oskarhuotari/HeartPCBGift/Stand.step

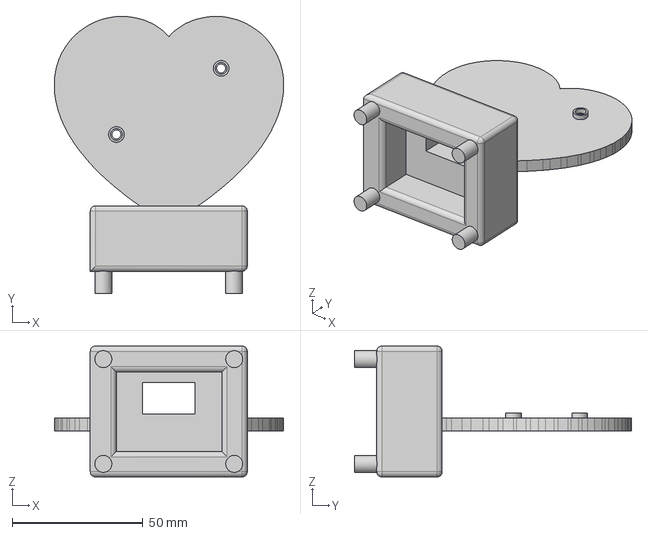
[picture p1: CAD file, 2026-10-22]
Stand.step
87.7 x 105.8 x 50.0 mm
