oskarhuotari/HeartPCBGift/schematic.pdf

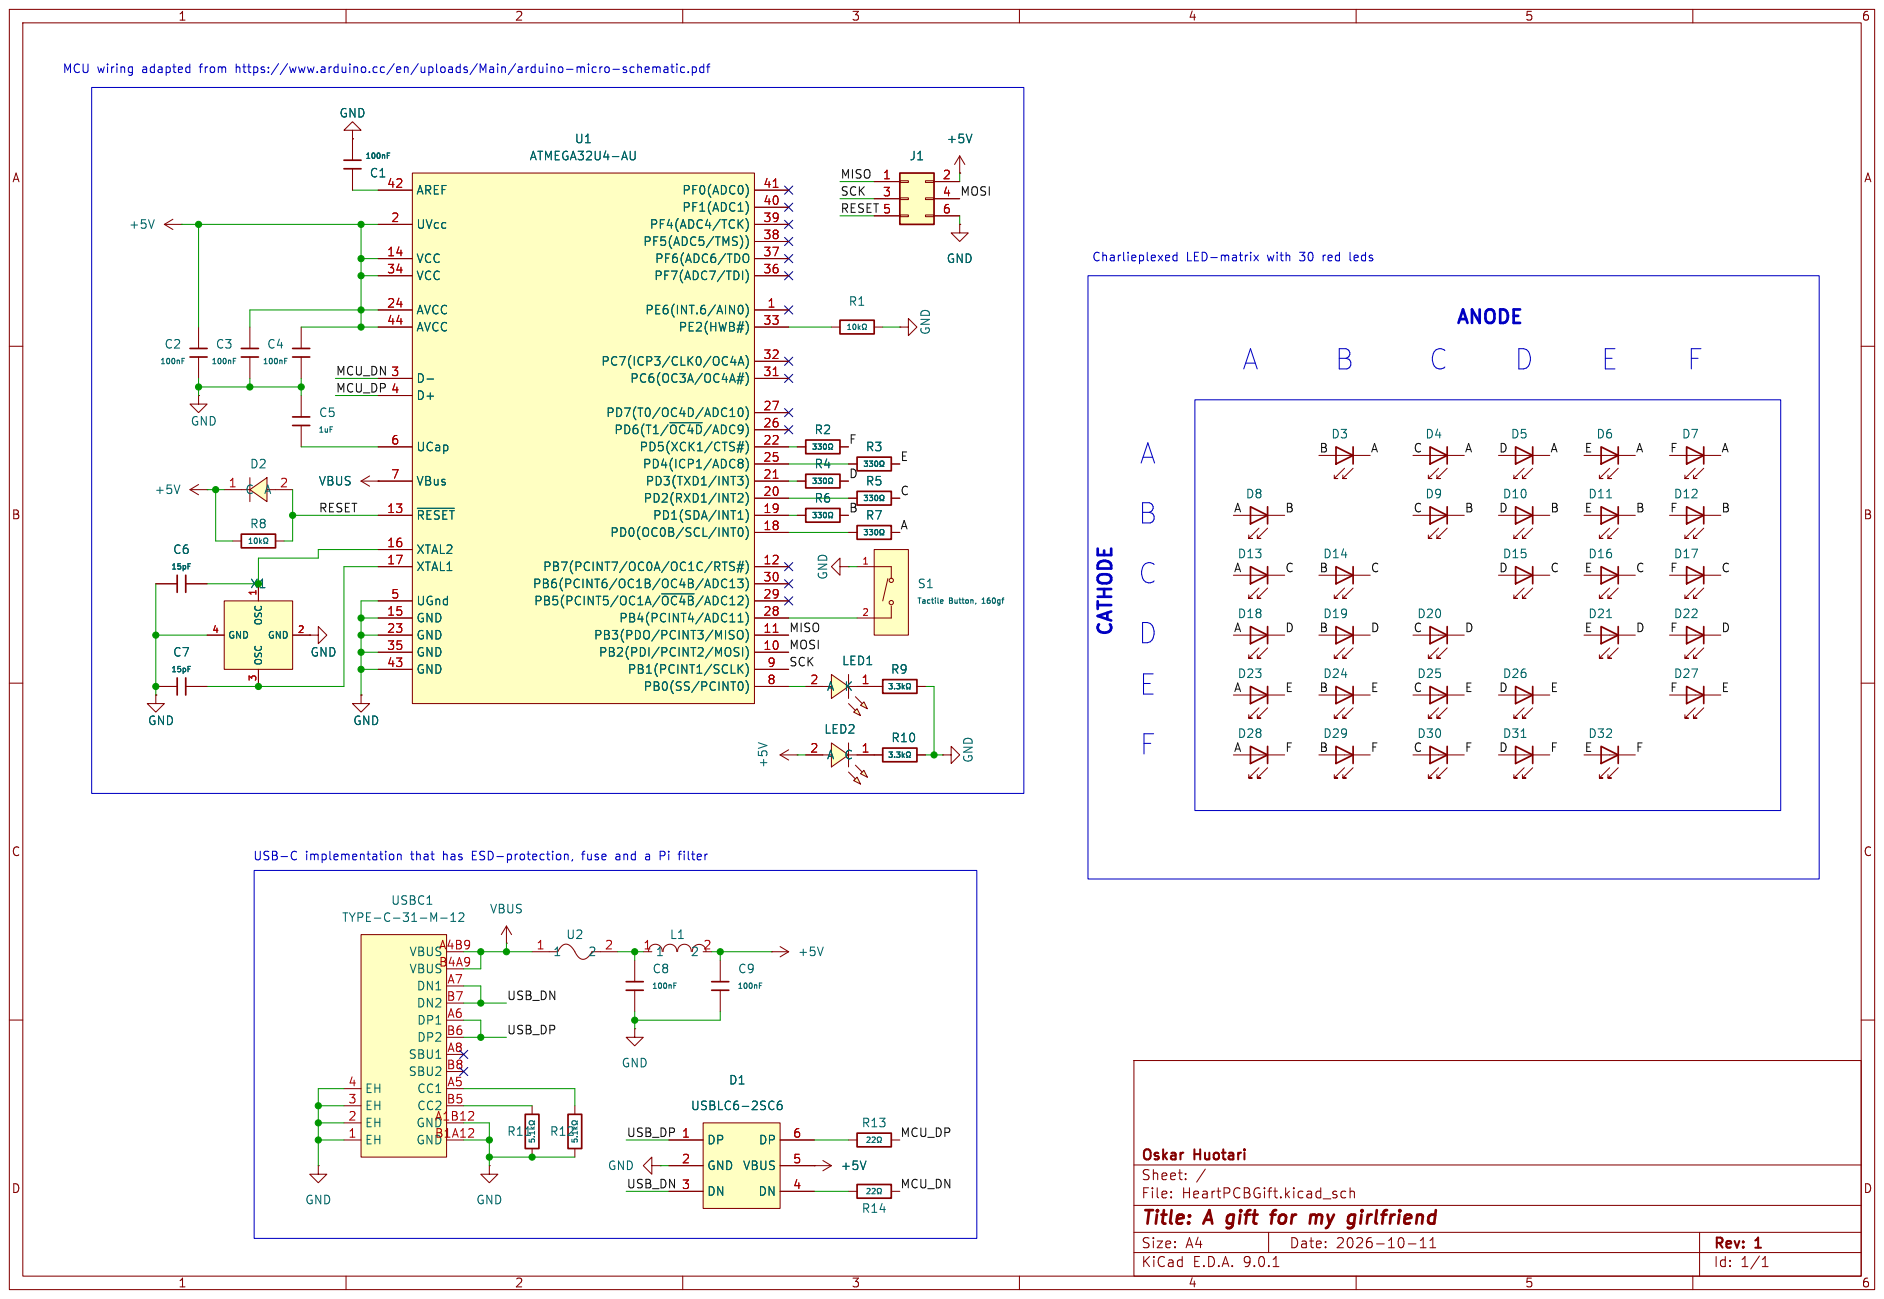
[picture p2: page 1]

MCU wiring adapted from https://www.arduino.cc/en/uploads/Main/arduino-micro-schematic.pdf

Id: 1/1 Title: A gift for my girlfriend
