oskarhuotari/HeartPCBGift/HeartPCBGift.kicad_pcb

## KiCad design HeartPCBGift.kicad_pcb (2026-10-20)

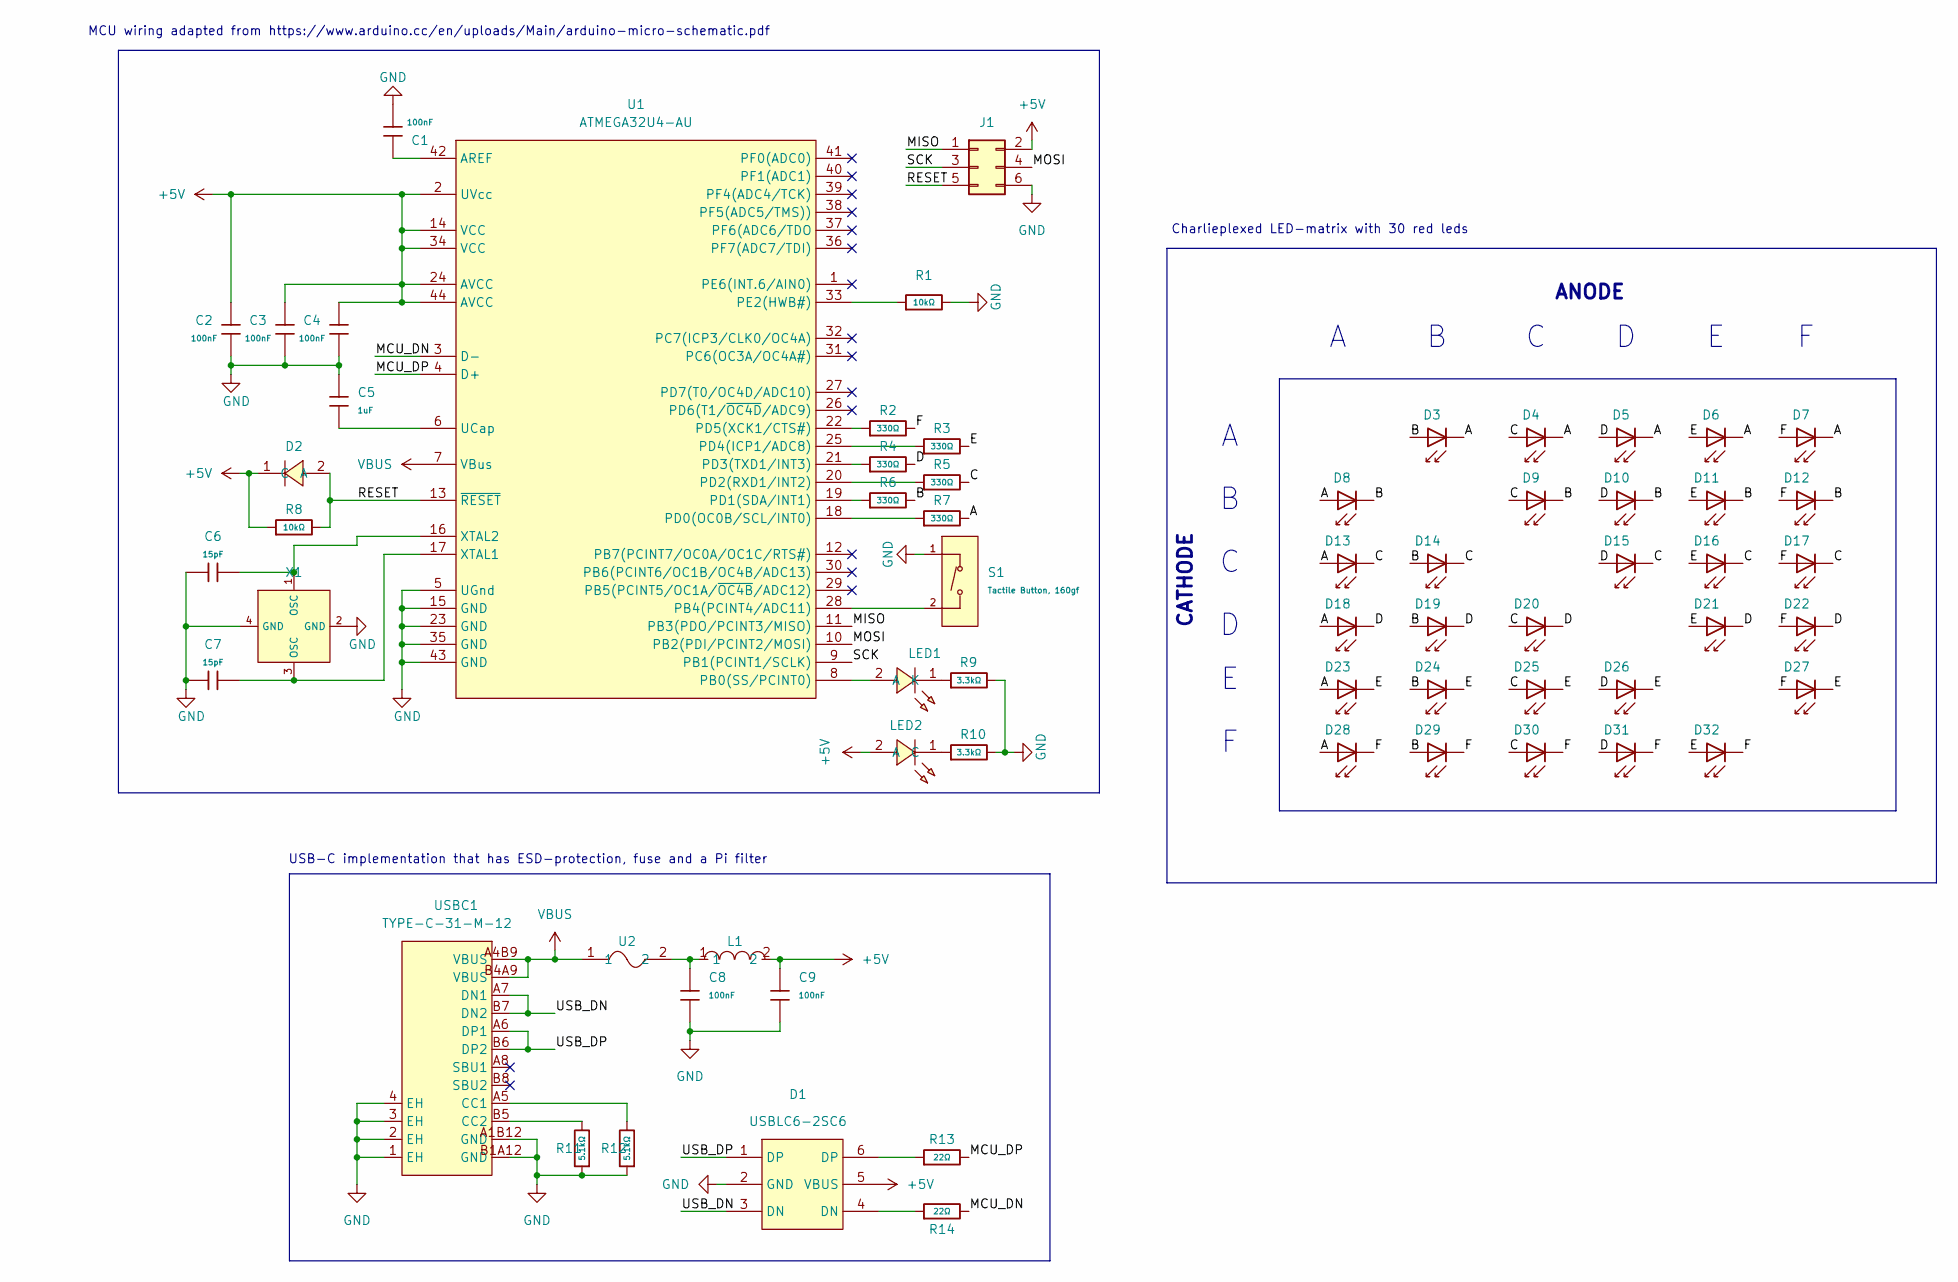
[picture p3: schematic HeartPCBGift.kicad_sch, A gift for my girlfriend]

Parts:
C1, C2, C3, C4, C8, C9: 100nF; C_0603; Voltage Rated 50V; Tolerance ±10%; Part CC0603KRX7R9BB104; LCSC C14663
C5: 1uF; C_0603; Voltage Rated 50V; Tolerance ±10%; Part CL10A105KB8NNNC; LCSC C15849
C6, C7: 15pF; C_0603; Voltage Rated 50V; Tolerance ±5%; Part CL10C150JB8NNNC; LCSC C1644
D1: USBLC6-2SC6; SOT-23-6_L2.9-W1.6-P0.95-LS2.8-BL; MPN USBLC6-2SC6; LCSC Part C7519
D2: 1N4448W_C5190208; SOD-123_L2.7-W1.6-LS3.7-RD; MPN 1N4448W; LCSC Part C5190208
D3, D4, D5, D6, D7, D8, D9, D10, D11, D12, D13, D14, D15, D16, D17, D18, D19, D20, D21, D22, D23, D24, D25, D26, D27, D28, D29, D30, D31, D32: Red; D_0805; Forward Voltage (VF) 1.6V~2.6V; Part NCD0805R1; LCSC C84256
J1: Conn_02x03_Odd_Even; PinHeader_2x03_P2.54mm_Vertical
L1: MPZ1608D101BTA00; L0603; MPN MPZ1608D101BTA00; LCSC Part C87554
LED1: XL-1608UBC-04; LED0603-RD_BLUE; MPN XL-1608UBC-04; LCSC Part C965807
LED2: F.0603.00025/P2-0603G1TS2-06T-002; LED0603-RD_GREEN; MPN F.0603.00025/P2-0603G1TS2-06T-002; LCSC Part C7496818
R1, R8: 10kΩ; R_0603; Overload Voltage (Max) 75V; Tolerance ±1%; Part 0603WAF1002T5E; LCSC C25804
R2, R3, R4, R5, R6, R7: 330Ω; R_0603; Overload Voltage (Max) 75V; Tolerance ±1%; Part 0603WAF3300T5E; LCSC C23138
R9, R10: 3.3kΩ; R_0603; Overload Voltage (Max) 75V; Tolerance ±1%; Part 0603WAF3301T5E; LCSC C22978
R11, R12: 5.1kΩ; R_0603; Overload Voltage (Max) 75V; Tolerance ±1%; Part 0603WAF5101T5E; LCSC C23186
R13, R14: 22Ω; R_0603; Overload Voltage (Max) 75V; Tolerance ±1%; Part 0603WAF220JT5E; LCSC C23345
S1: Tactile Button, 160gf; SW_TS-1088-AR02016; Voltage Rating (Dc) 12V; Part TS-1088-AR02016; LCSC C720477
U1: ATMEGA32U4-AU; QFP-44_L10.0-W10.0-P0.80-LS13.2-BL; MPN ATMEGA32U4-AU; LCSC Part C44854
U2: MF-MSMF050-2; F1812; MPN MF-MSMF050-2; LCSC Part C17313
USBC1: TYPE-C-31-M-12; USB-C_SMD-TYPE-C-31-M-12_1; MPN TYPE-C-31-M-12; LCSC Part C165948
X1: X322516MLB4SI; OSC-SMD_4P-L3.2-W2.5-BL; Frequency Tolerance ±10ppm; Part X322516MLB4SI; LCSC C13738

Connections:
+5V: C2.2, C3.2, C4.2, C9.1, D1.5 (VBUS), D2.1 (C), J1.2, L1.2, LED2.2 (A), R8.1, U1.2 (UVcc), U1.14 (VCC), U1.24 (AVCC), U1.34 (VCC), U1.44 (AVCC)
/A: D3.1, D4.1, D5.1, D6.1, D7.1, D8.2, D13.2, D18.2, D23.2, D28.2, R7.2
/B: D3.2, D8.1, D9.1, D10.1, D11.1, D12.1, D14.2, D19.2, D24.2, D29.2, R6.2
/C: D4.2, D9.2, D13.1, D14.1, D15.1, D16.1, D17.1, D20.2, D25.2, D30.2, R5.2
/D: D5.2, D10.2, D15.2, D18.1, D19.1, D20.1, D21.1, D22.1, D26.2, D31.2, R4.2
/E: D6.2, D11.2, D16.2, D21.2, D23.1, D24.1, D25.1, D26.1, D27.1, D32.2, R3.2
/F: D7.2, D12.2, D17.2, D22.2, D27.2, D28.1, D29.1, D30.1, D31.1, D32.1, R2.2
/MCU_DN: R14.2, U1.3 (D-)
/MCU_DP: R13.2, U1.4 (D+)
/MISO: J1.1, U1.11 (PB3(PDO/PCINT3/MISO))
/MOSI: J1.4, U1.10 (PB2(PDI/PCINT2/MOSI))
/RESET: D2.2 (A), J1.5, R8.2, U1.13 (~RESET)
/SCK: J1.3, U1.9 (PB1(PCINT1/SCLK))
/USB_DN: D1.3 (DN), USBC1.A7 (DN1), USBC1.B7 (DN2)
/USB_DP: D1.1 (DP), USBC1.A6 (DP1), USBC1.B6 (DP2)
GND: C1.1, C2.1, C3.1, C4.1, C5.1, C6.1, C7.1, C8.2, C9.2, D1.2 (GND), J1.6, R1.2, R9.2, R10.2, R11.1, R12.1, S1.1 (A), U1.5 (UGnd), U1.15 (GND), U1.23 (GND), U1.35 (GND), U1.43 (GND), USBC1.1 (EH), USBC1.2 (EH), USBC1.3 (EH), USBC1.4 (EH), USBC1.A1B12 (GND), USBC1.B1A12 (GND), X1.2 (GND), X1.4 (GND)
unnamed: C8.1, L1.1, U2.2
unnamed: D1.4 (DN), R14.1
unnamed: D1.6 (DP), R13.1
unnamed: LED1.2 (A), U1.8 (PB0(SS/PCINT0))
unnamed: LED1.1 (K), R9.1
unnamed: LED2.1 (C), R10.1
unnamed: S1.2 (B), U1.28 (PB4(PCINT4/ADC11))
unnamed: C1.2, U1.42 (AREF)
unnamed: R7.1, U1.18 (PD0(OC0B/SCL/INT0))
unnamed: R6.1, U1.19 (PD1(SDA/INT1))
unnamed: R5.1, U1.20 (PD2(RXD1/INT2))
unnamed: R4.1, U1.21 (PD3(TXD1/INT3))
unnamed: R3.1, U1.25 (PD4(ICP1/ADC8))
unnamed: R2.1, U1.22 (PD5(XCK1/CTS#))
unnamed: R1.1, U1.33 (PE2(HWB#))
unnamed: C5.2, U1.6 (UCap)
unnamed: C7.2, U1.17 (XTAL1), X1.3 (OSC)
unnamed: C6.2, U1.16 (XTAL2), X1.1 (OSC)
unnamed: R12.2, USBC1.A5 (CC1)
unnamed: R11.2, USBC1.B5 (CC2)
VBUS: U1.7 (VBus), U2.1, USBC1.A4B9 (VBUS), USBC1.B4A9 (VBUS)

Notes on the sheet:
Charlieplexed LED-matrix with 30 red leds
USB-C implementation that has ESD-protection, fuse and a Pi filter
ANODE
MCU wiring adapted from https://www.arduino.cc/en/uploads/Main/arduino-micro-schematic.pdf
CATHODE

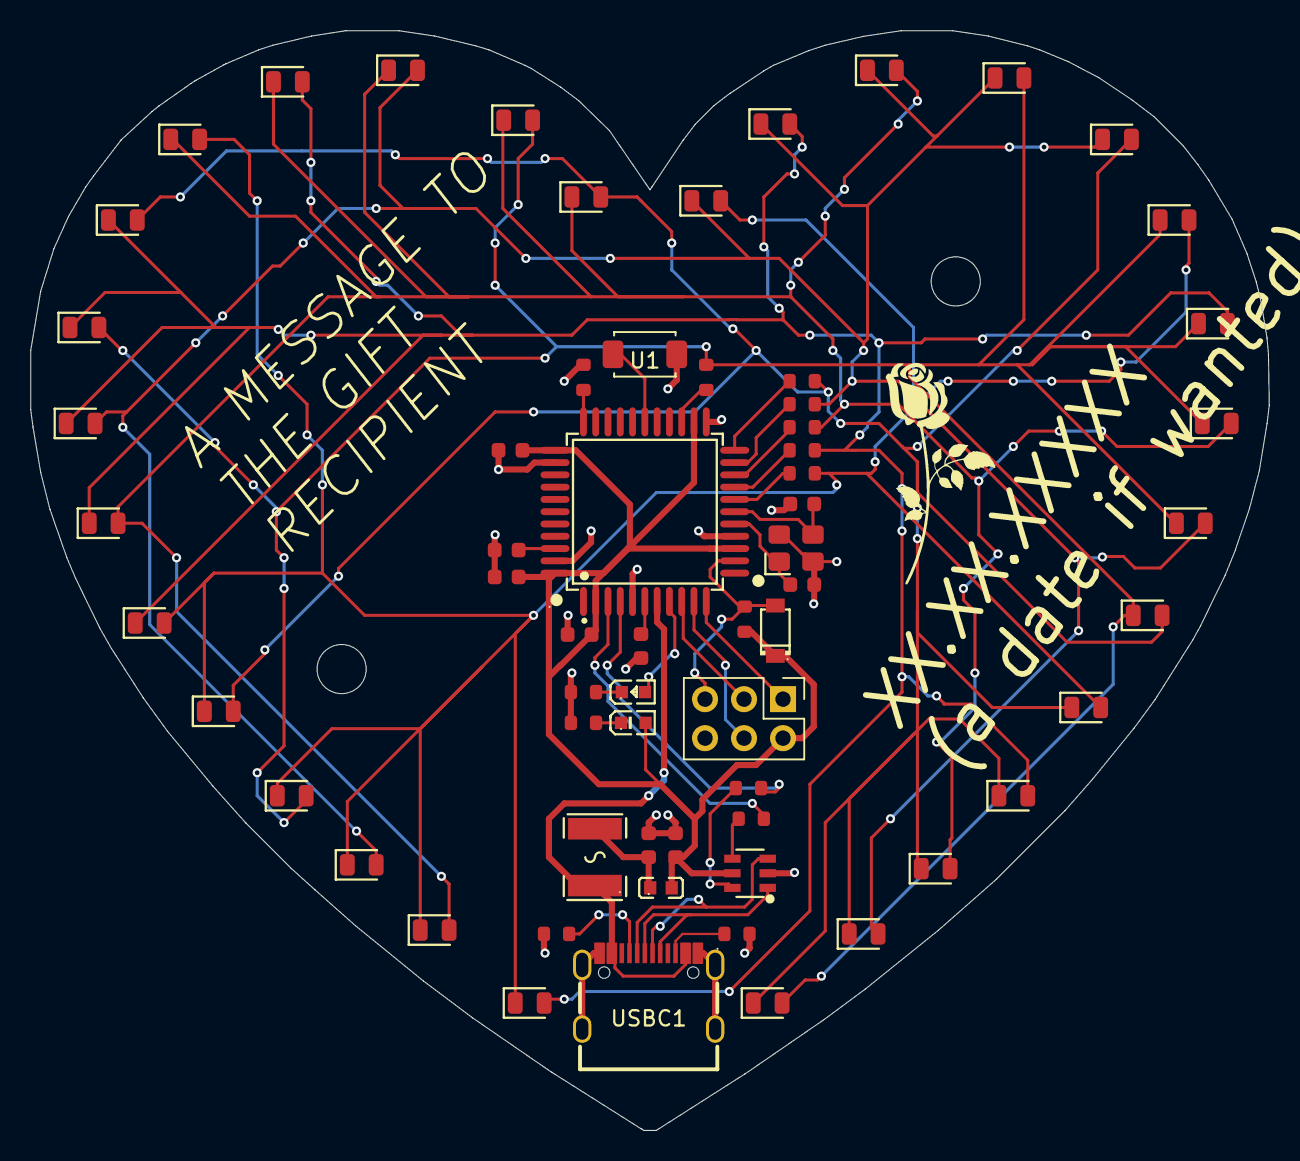
[picture p4: board HeartPCBGift.kicad_pcb from above]

Board: 2 copper layers, 80.7 x 71.6 mm, 64 parts (0 on the bottom side), 37 nets.
