oskarhuotari/HeartPCBGift/(commit log)

2026-10-20 Commit of the PCB design
    [HeartPCBGift.kicad_pcb, HeartPCBGift.kicad_sch]
2026-10-20 Removed useless files
    [HeartPCBGift.kicad_pcb]
2026-10-20 Added a schematic PDF
2026-10-22 Added a stand step file
    [Stand.step]
2026-11-04 Add Arduino sketch for LED control
2026-11-04 Enhance README with details on PCB and functionality
    Added descriptions for the PCB, stand, and code functionality.
